InterstitialTech/automato-relay/README.md

# automato-relay
relay module for the Automato ecosystem

Schematic

Layout

Render
