InterstitialTech/automato-relay/kicad/automato-relay.kicad_pcb

## KiCad design kicad/automato-relay.kicad_pcb (2022-04-04)

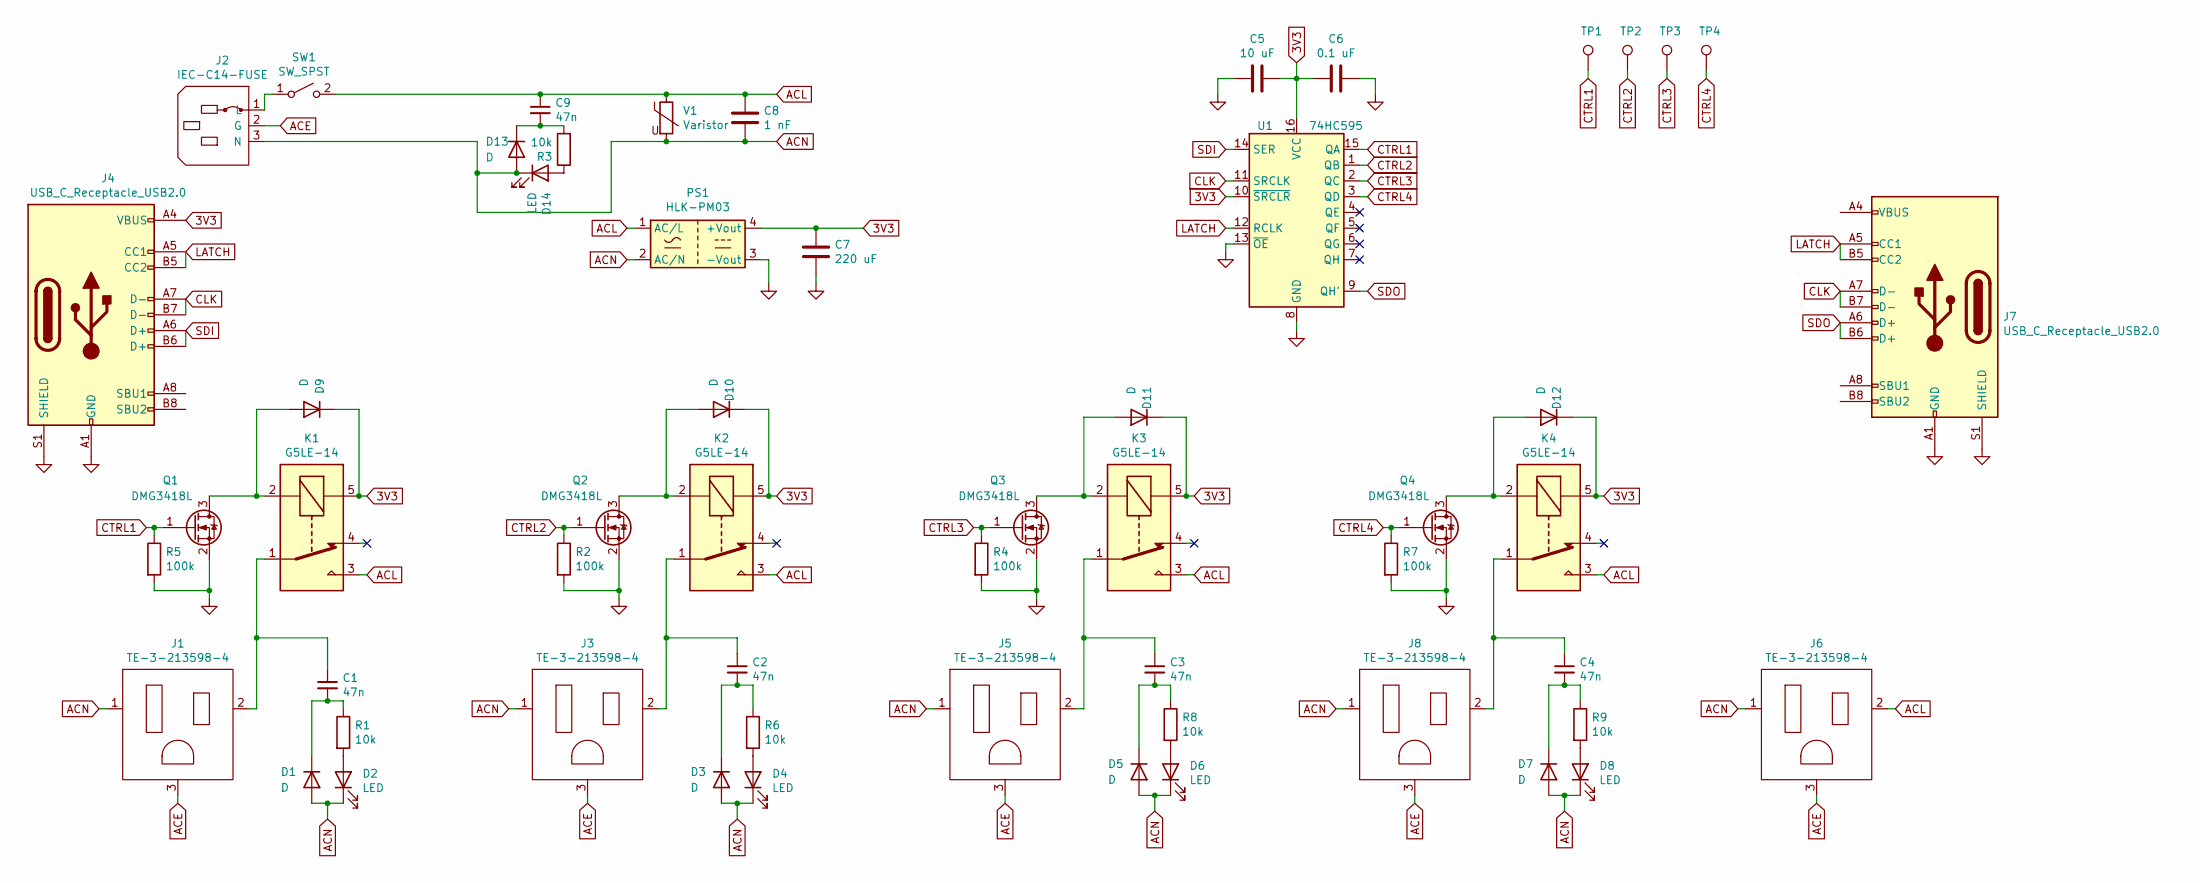
[picture p1: schematic automato-relay.sch, Automato Relay Rev 1]

Parts:
C1, C2, C3, C4, C9: 47n; C_1206_3216Metric
C5: 10 uF; C_1206_3216Metric
C6: 0.1 uF; C_1206_3216Metric
C7: 220 uF; CP_Radial_D6.3mm_P2.50mm
C8: 1 nF; C_Disc_D7.5mm_W5.0mm_P10.00mm
D1, D3, D5, D7, D13: D; D_SOD-123
D2, D4, D6, D8, D14: LED; LED_1206_3216Metric
D9, D10, D11, D12: D; D_SOT-23_ANK
J1, J3, J5, J6, J8: TE-3-213598-4
J2: IEC-C14-FUSE; PF0011-15-PC
J4, J7: USB_C_Receptacle_USB2.0; USB_C_Receptacle_GCT-USB4105
K1, K2, K3, K4: G5LE-14; Relay_SPDT_Omron-G5LE-1
PS1: HLK-PM03; Converter_ACDC_HiLink_HLK-PMxx
Q1, Q2, Q3, Q4: DMG3418L; SOT-23
R1, R3, R6, R8, R9: 10k; R_0805_2012Metric
R2, R4, R5, R7: 100k; R_0805_2012Metric
SW1: SW_SPST; RA1H1C112R
TP1, TP2, TP3, TP4: TestPoint; PinHeader_1x01_P2.54mm_Vertical
U1: 74HC595; SO-16_3.9x9.9mm_P1.27mm
V1: Varistor; RV_Disc_D15.5mm_W3.9mm_P7.5mm

Connections:
3V3: C5.1, C6.2, C7.1, D9.1 (K), D10.1 (K), D11.1 (K), D12.1 (K), J4.A4 (VBUS), J4.A9 (VBUS), J4.B4 (VBUS), J4.B9 (VBUS), K1.5, K2.5, K3.5, K4.5, PS1.4 (+Vout), U1.10 (~SRCLR), U1.16 (VCC)
ACE: J1.3 (Earth), J2.2 (G), J3.3 (Earth), J5.3 (Earth), J6.3 (Earth), J8.3 (Earth)
ACL: C8.1, C9.1, J6.2 (Hot), K1.3, K2.3, K3.3, K4.3, PS1.1 (AC/L), SW1.2 (B), V1.1
ACN: C8.2, D1.2 (A), D2.1 (K), D3.2 (A), D4.1 (K), D5.2 (A), D6.1 (K), D7.2 (A), D8.1 (K), D13.2 (A), D14.1 (K), J1.1 (Neutral), J2.3 (N), J3.1 (Neutral), J5.1 (Neutral), J6.1 (Neutral), J8.1 (Neutral), PS1.2 (AC/N), V1.2
CLK: J4.A7 (D-), J4.B7 (D-), J7.A7 (D-), J7.B7 (D-), U1.11 (SRCLK)
CTRL1: Q1.1 (G), R5.1, TP1.1, U1.15 (QA)
CTRL2: Q2.1 (G), R2.1, TP2.1, U1.1 (QB)
CTRL3: Q3.1 (G), R4.1, TP3.1, U1.2 (QC)
CTRL4: Q4.1 (G), R7.1, TP4.1, U1.3 (QD)
GND: C5.2, C6.1, C7.2, J4.A1 (GND), J4.A12 (GND), J4.B1 (GND), J4.B12 (GND), J4.S1 (SHIELD), J7.A1 (GND), J7.A12 (GND), J7.B1 (GND), J7.B12 (GND), J7.S1 (SHIELD), PS1.3 (-Vout), Q1.2 (S), Q2.2 (S), Q3.2 (S), Q4.2 (S), R2.2, R4.2, R5.2, R7.2, U1.8 (GND), U1.13 (~OE)
LATCH: J4.A5 (CC1), J4.B5 (CC2), J7.A5 (CC1), J7.B5 (CC2), U1.12 (RCLK)
unnamed: C1.1, J1.2 (Hot), K1.1
unnamed: C1.2, D1.1 (K), R1.1
unnamed: C2.1, J3.2 (Hot), K2.1
unnamed: C2.2, D3.1 (K), R6.1
unnamed: C3.1, J5.2 (Hot), K3.1
unnamed: C3.2, D5.1 (K), R8.1
unnamed: C4.1, J8.2 (Hot), K4.1
unnamed: C4.2, D7.1 (K), R9.1
unnamed: C9.2, D13.1 (K), R3.2
unnamed: D2.2 (A), R1.2
unnamed: D4.2 (A), R6.2
unnamed: D6.2 (A), R8.2
unnamed: D8.2 (A), R9.2
unnamed: D9.2 (A), K1.2, Q1.3 (D)
unnamed: D10.2 (A), K2.2, Q2.3 (D)
unnamed: D11.2 (A), K3.2, Q3.3 (D)
unnamed: D12.2 (A), K4.2, Q4.3 (D)
unnamed: D14.2 (A), R3.1
unnamed: J2.1 (L), SW1.1 (A)
unnamed: J7.A4 (VBUS), J7.A9 (VBUS), J7.B4 (VBUS), J7.B9 (VBUS)
SDI: J4.A6 (D+), J4.B6 (D+), U1.14 (SER)
SDO: J7.A6 (D+), J7.B6 (D+), U1.9 (QH')

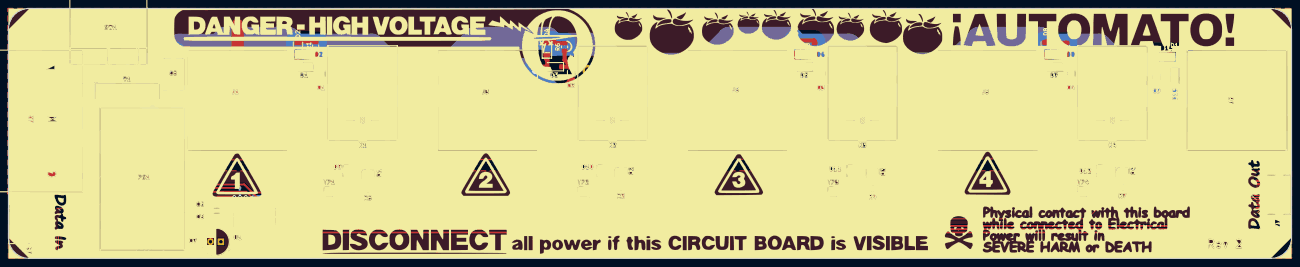
[picture p2: board automato-relay.kicad_pcb from above]

Board: 2 copper layers, 308.0 x 60.0 mm, 56 parts (0 on the bottom side), 33 nets.
