InterstitialTech/automato-relay/(commit log)

2021-02-03 fix copy-paste error: CTRL1/2/3/4
    [automato-relay.sch]
2021-02-05 annotate symbols
    [automato-relay.sch]
2021-02-08 remove SPDT switches
    [automato-relay.sch]
2021-02-08 ground LEDs through ACN
    [automato-relay.sch]
2021-02-08 add low-side mosfets for relay coils
    [automato-relay.sch]
2021-02-08 add earth ground connections
    [automato-relay.sch]
2021-02-08 add pull-down resistors to MOSFET gates
    [automato-relay.sch]
2021-02-09 add TE-3-213598-4 symbol
    [automato-relay.sch]
2021-02-09 add TE-3-213598-4 footprint
2021-02-09 increase schematic width
    [automato-relay.sch]
2021-02-09 remove 3V3 from J7
    [automato-relay.sch]
2021-02-11 add bom.csv
    [bom.csv]
2021-02-11 README.md: add schematic image
2021-02-23 All traces routed
    MOV added, 10 hours in. Final approval of layout. Power planes to pour.
    [automato-relay.kicad_pcb, automato-relay.sch, bom.csv]
2021-02-25 Final Rev
    Added varistor, poured power planes, added mounting holes, modified data headers, added space for IEC connector.
    [automato-relay.kicad_pcb, bom.csv]
2021-02-25 resized capacitors
    forgot to resize capacitors in schematic
    [automato-relay.sch]
2021-02-25 layout: remove vias on SDO
    [automato-relay.kicad_pcb]
2021-02-25 layout: add Earth pour on southern half of board (both sides)
    [automato-relay.kicad_pcb]
2021-02-25 layout: add GND and 3V3 pours on northern half of board
    [automato-relay.kicad_pcb]
2021-02-25 layout: modify and move revision label
    [automato-relay.kicad_pcb]
2021-02-25 layout: replace mounting holes with proper M3 pads, add rounded corners
    [automato-relay.kicad_pcb]
2021-02-25 add testpoints for CTRL1,2,3,4
    [automato-relay.kicad_pcb, automato-relay.sch]
2021-02-25 move bom.csv to top level
    [bom.csv]
2021-02-25 schematic: add metadata
    [automato-relay.sch]
2021-03-06 bom.csv: correct quanitity on BAS16LT1G diodes
    [bom.csv]
2021-03-08 add PhoenixContact_1935190_1x5.kicad_mod
2021-03-10 update J4/J7 footprints to Phoenix 1935190
    [automato-relay.kicad_pcb, automato-relay.sch]
2021-03-10 layout: add silkscreen pin labels for J4 and J7
    [automato-relay.kicad_pcb]
2021-07-09 add decoupling capacitors for the 74HC595
    [automato-relay.kicad_pcb, automato-relay.sch, bom.csv]
2021-07-09 add decoupling capacitor for the HLK-PM03
    [automato-relay.kicad_pcb, automato-relay.sch, bom.csv]
2021-07-09 add X1 safety capacitor across AC lines
    [automato-relay.kicad_pcb, automato-relay.sch, bom.csv]
2021-07-16 layout: increase priority level on rear ACL zone
    [automato-relay.kicad_pcb]
2021-07-16 layout: minor changes to appease DRC
    [automato-relay.kicad_pcb]
2021-09-14 bom.csv: fix old reference designators R1, R3
    [bom.csv]
2022-02-15 Changed Indicator bypass diodes to 1000V reverse-voltage diodes (1n4007)
    [automato-relay.sch]
2022-02-15 Changed indicator diode footprint and re-routed
    [automato-relay.kicad_pcb]
2022-02-15 updated BOM to reflect indicator bypass diode change
    [bom.csv]
2022-03-06 added fused inlet
2022-03-06 swapped iec inlet pins to match footprint
2022-03-06 removed screw terminals, add IEC inlet + switch
    [automato-relay.sch]
2022-03-06 Starting to play with pcb layout for new rev.
    Moved outlets to top of board to make power switch placement more sensical.
    [automato-relay.kicad_pcb]
2022-03-06 routed high power section
    [automato-relay.kicad_pcb]
2022-03-07 playing around with 5-pin connector location
    [automato-relay.kicad_pcb]
2022-03-10 replaced 5-pin connectors with usb-c receptacles
    [automato-relay.sch]
2022-03-10 add usb-c receptacles, begin digital routing
    [automato-relay.kicad_pcb]
2022-03-10 finished routing logic
    [automato-relay.kicad_pcb]
2022-03-10 mostly finished power routing
    [automato-relay.kicad_pcb]
2022-03-10 routing for v2 looking good. waiting for review
    [automato-relay.kicad_pcb]
2022-03-10 replaced screw terminals with usb-C
    [automato-relay.sch]
2022-03-11 shifted usb-C connector location
    [automato-relay.kicad_pcb]
2022-03-12 add silk screen footprint
2022-03-12 finalizing v2 silk screen. GERB EXPORT
    [automato-relay.kicad_pcb]
2022-03-13 update usb-C receptacle footprint
    for yellow soldermask, minimum thickness is 0.22mm
2022-03-13 update usb-C receptacles
    [automato-relay.kicad_pcb]
2022-03-27 added resistors to led indicators
    [automato-relay.sch]
2022-03-27 added resistors and thermal spacing on pours
    [automato-relay.kicad_pcb]
2022-03-27 add automato-relay-eu
    [automato-relay-eu.kicad_pcb, automato-relay-eu.sch]
2022-04-04 change usb c -> spi pinout
    [automato-relay.kicad_pcb, automato-relay.sch]
